kahvell/pcb_projekt1/projekt/soldermask_stop_bottom.pdf

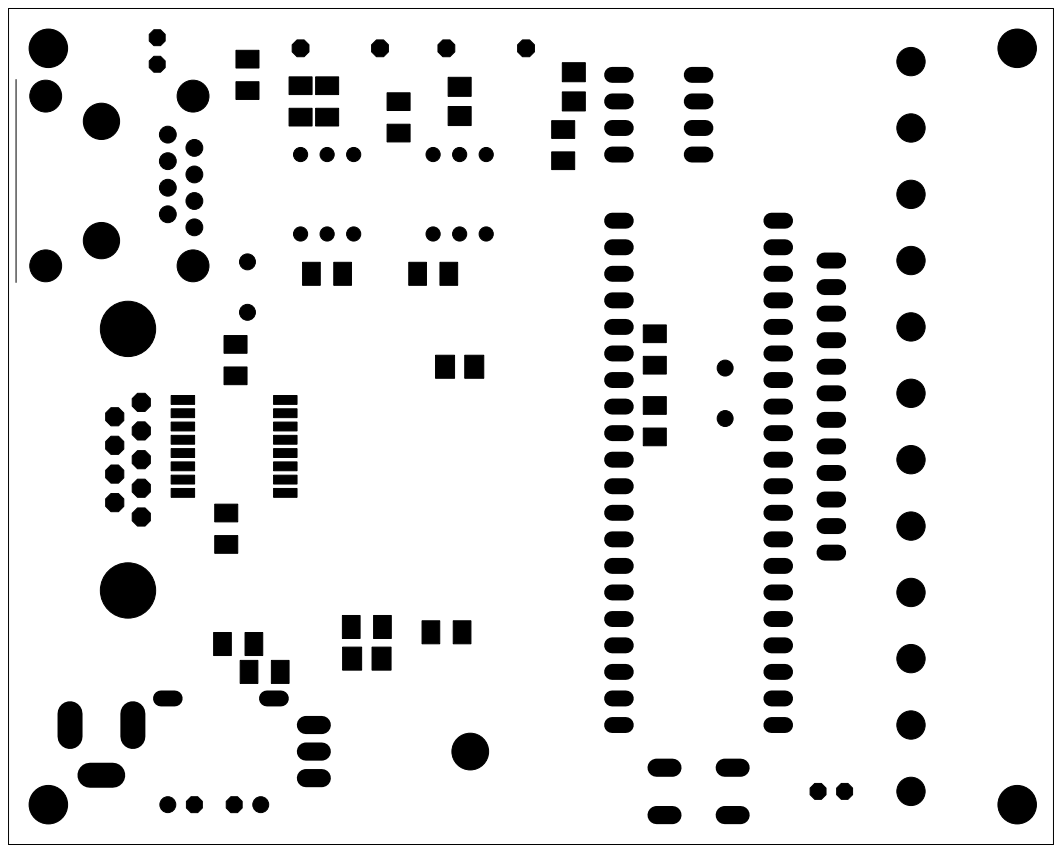
[picture p11: page 1]
