kahvell/pcb_projekt1/projekt/soldermask_stop_top.pdf

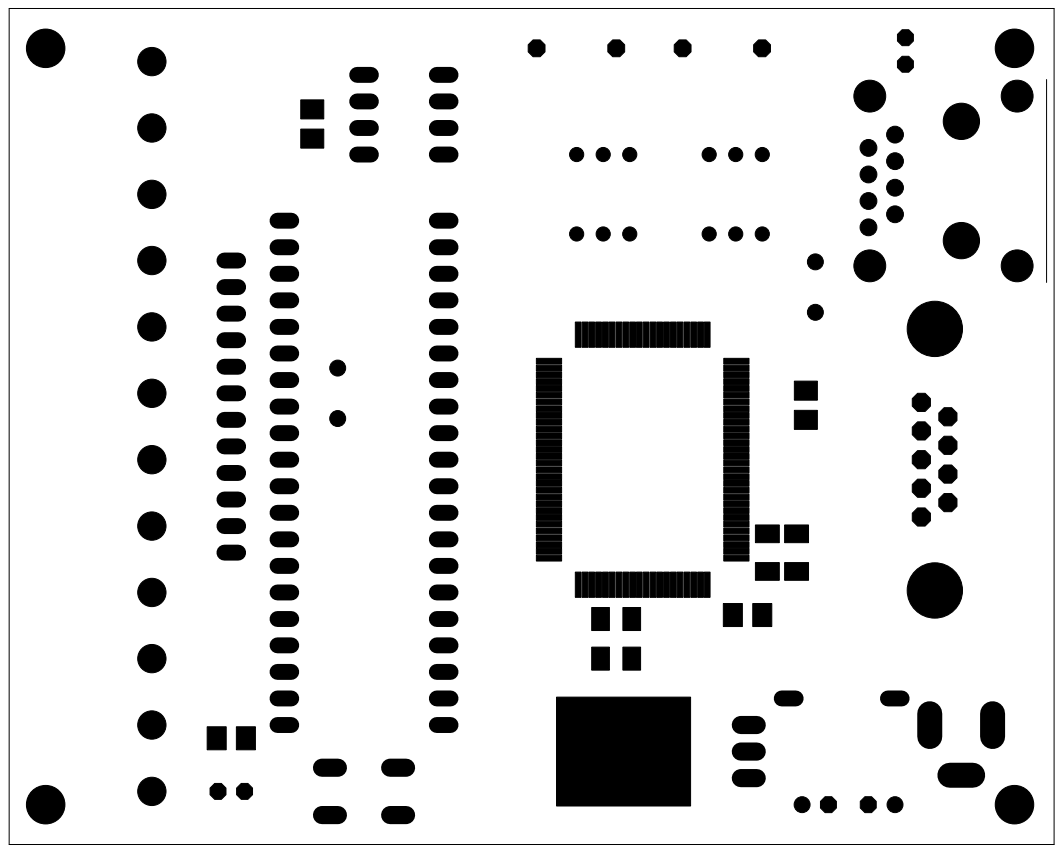
[picture p12: page 1]
