kahvell/pcb_projekt1/tutorial2/Eval/Eval.pdf

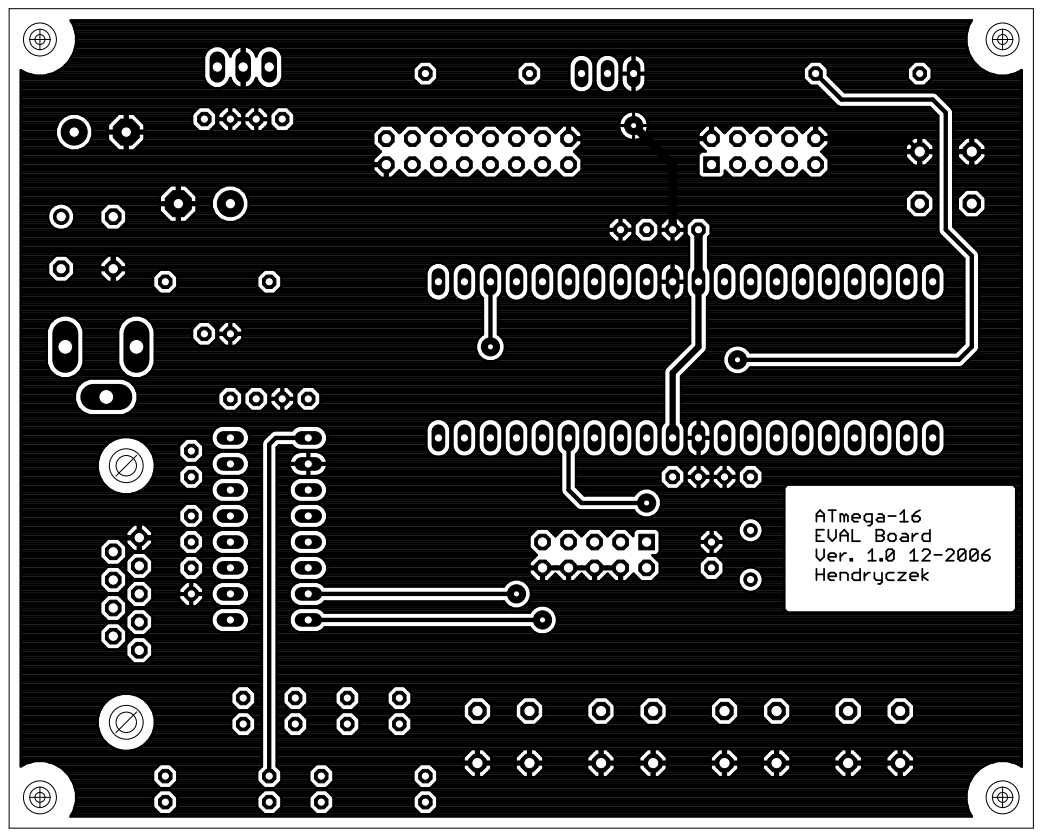
[picture p13: page 1]
