kahvell/pcb_projekt1/projekt/bottom.pdf

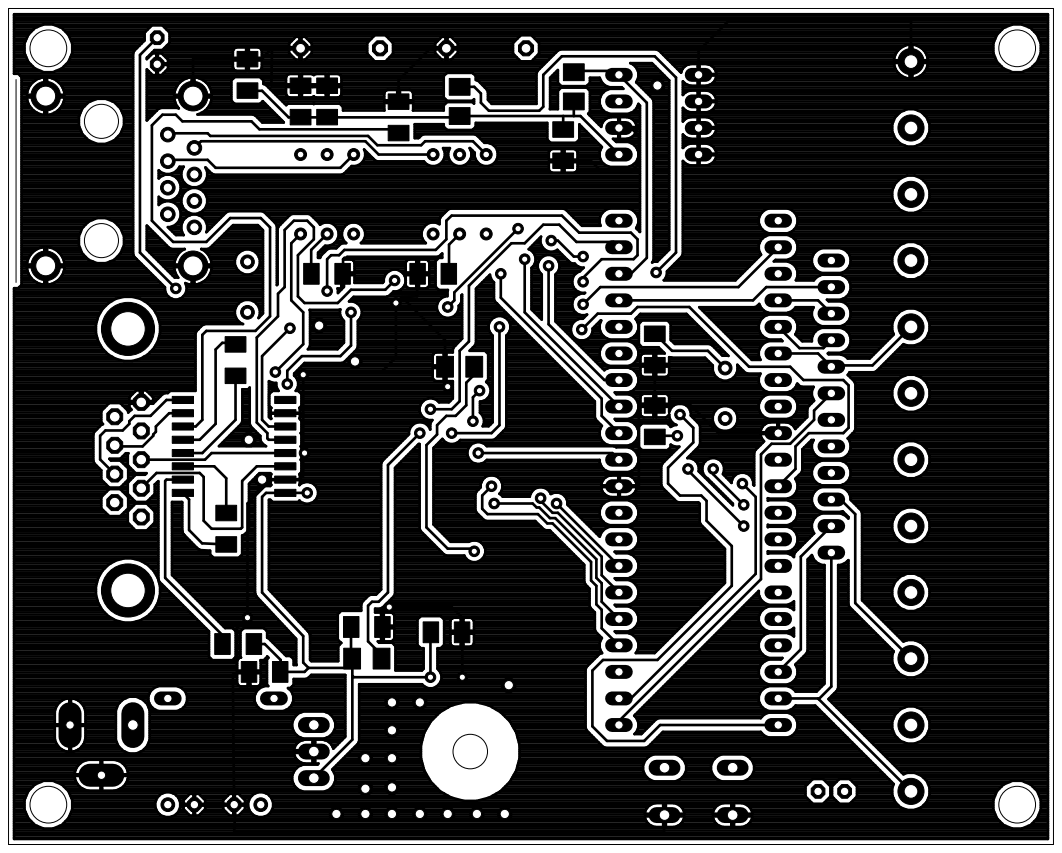
[picture p14: page 1]
