kahvell/pcb_projekt1/projekt/silkscreen_bottom.pdf

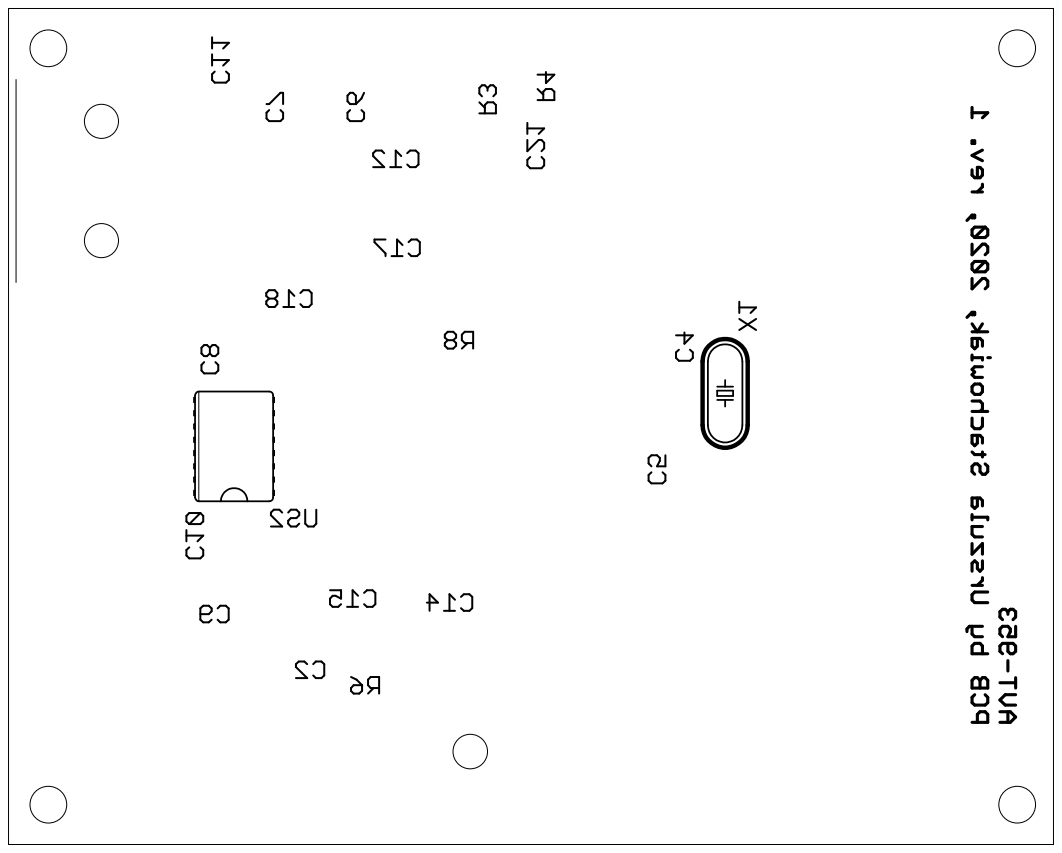
[picture p15: page 1]
