kahvell/pcb_projekt1/projekt/silkscreen_top.pdf

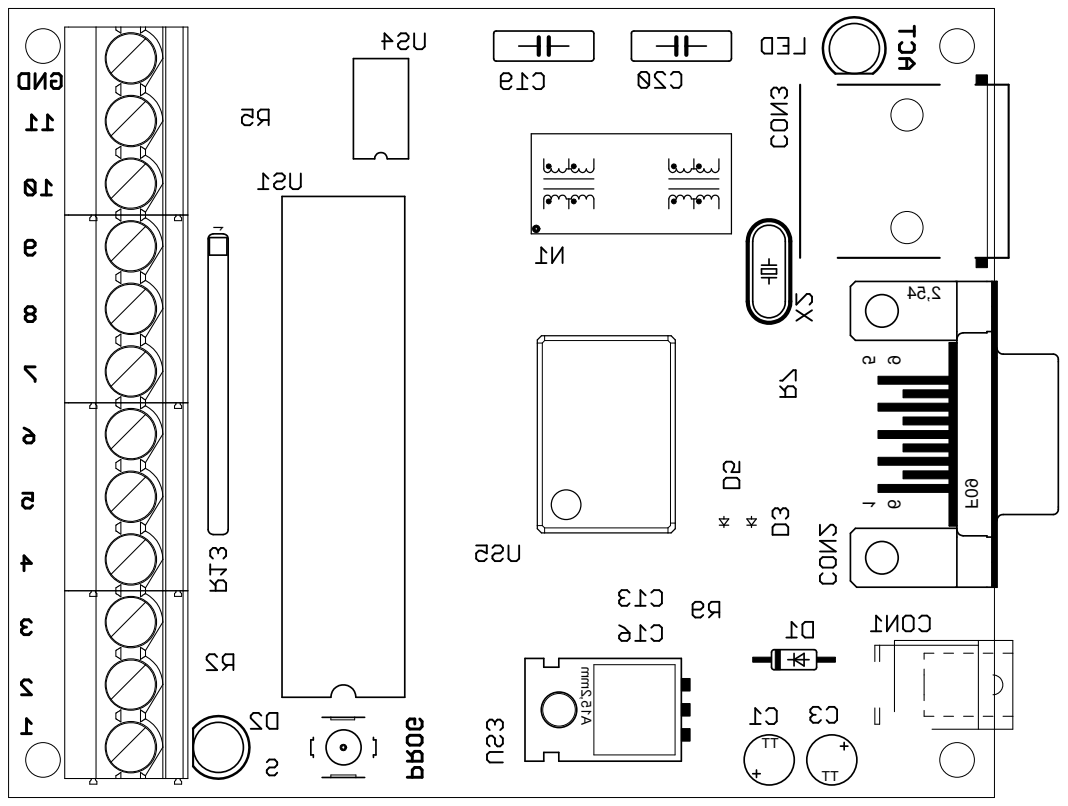
[picture p16: page 1]
