kahvell/pcb_projekt1/projekt/top.pdf

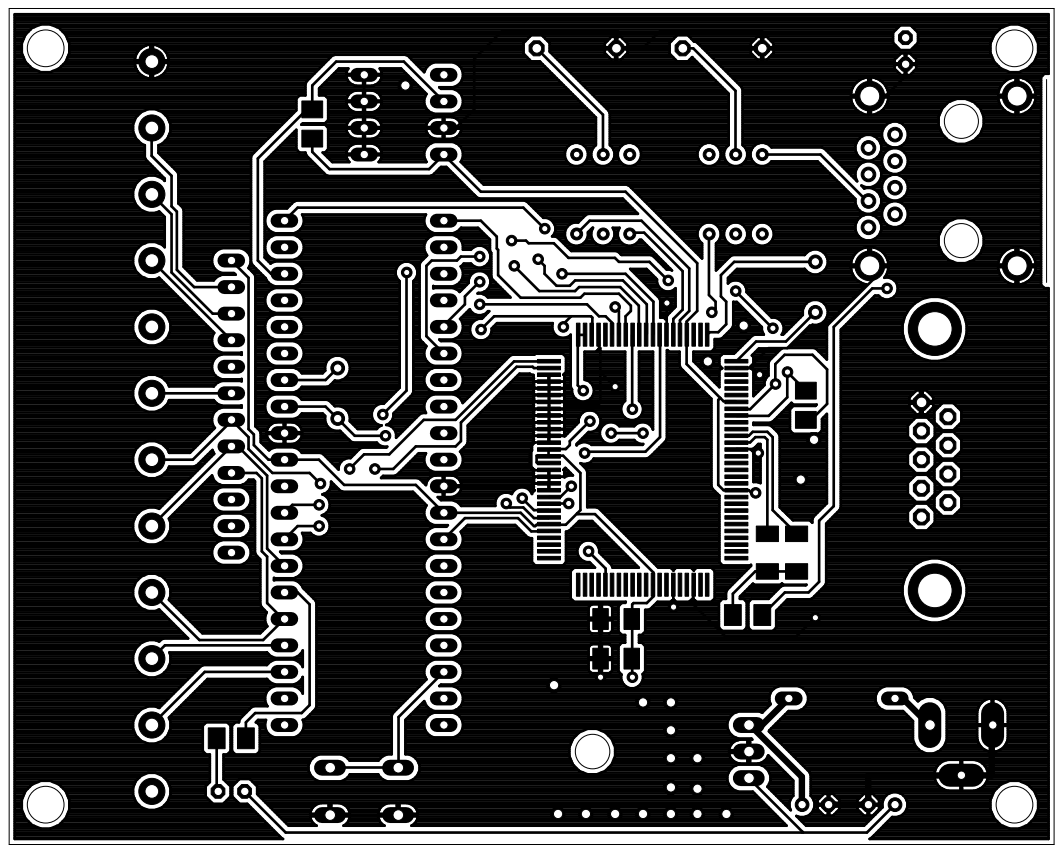
[picture p17: page 1]
