kahvell/pcb_projekt1/(list of files, drawings)

Other design files:
projekt/fw/8999/Cyfrowe wejscia LAN.PCB
