kahvell/pcb_projekt1/projekt/avt953.brd

## EAGLE design projekt/avt953.brd (2020-05-01)

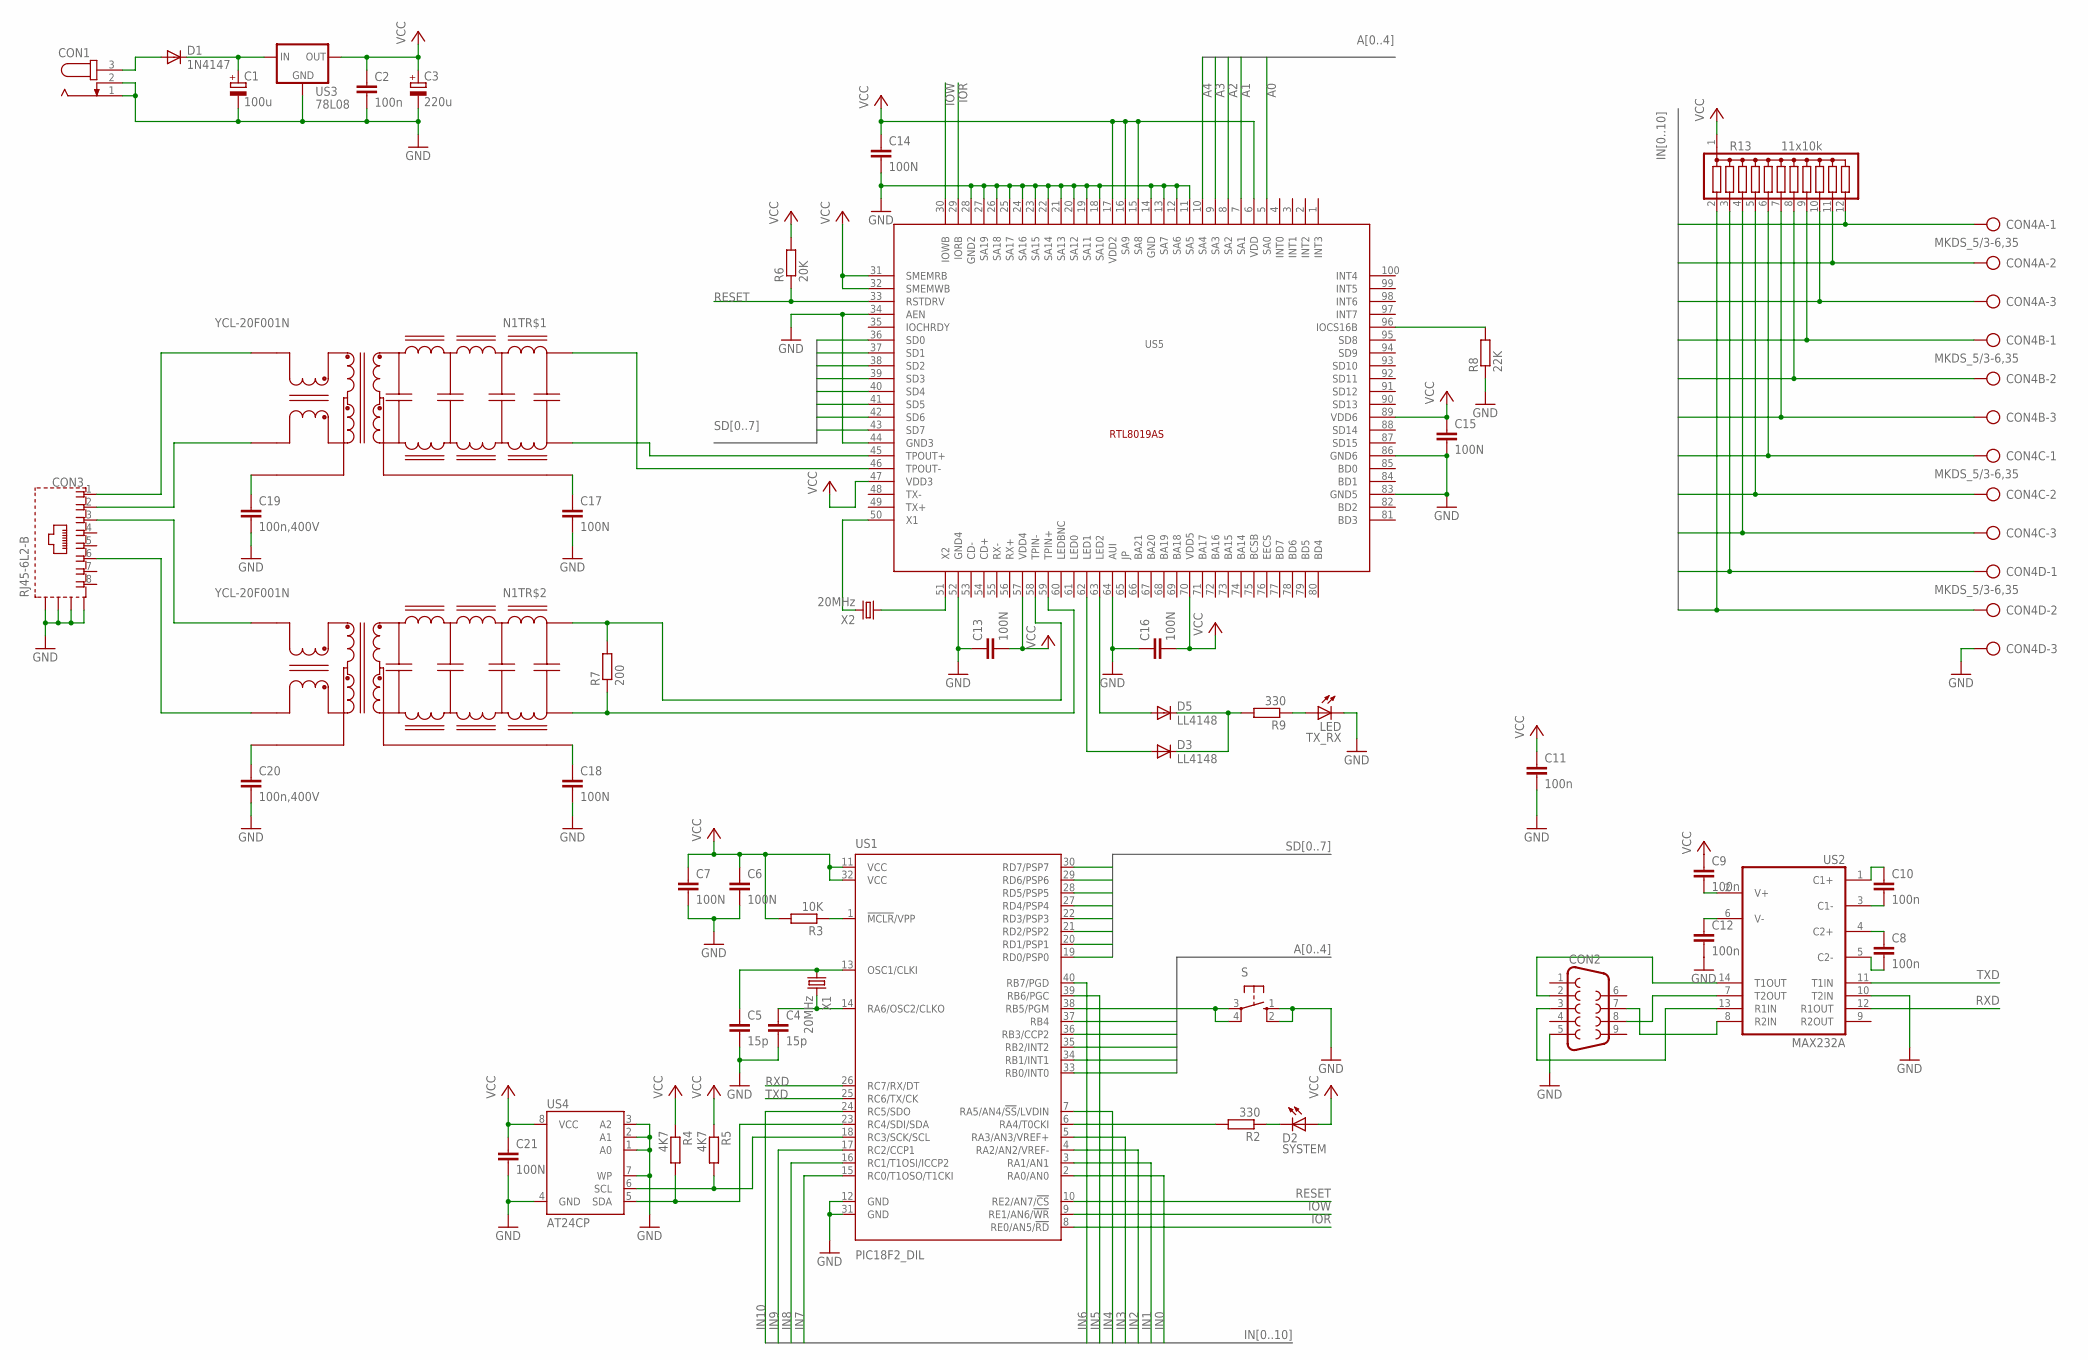
[picture p18: schematic avt953.sch]

Parts:
C1: 100u; TT2D5
C2, C8, C9, C10, C11, C12: 100n; C1206K
C3: 220u; TT2D5
C4, C5: 15p; C1206K
C6, C7, C13, C14, C15, C16, C17, C18, C21: 100N; C1206K
C19, C20: 100n,400V; C075-032X103
CON1: JACK-PLUG0; SPC4077
CON2: F09HP
CON3: RJ45-6L2-B; RJ45-SHIELD2
CON4A, CON4B, CON4C, CON4D: MKDS_5/3-6,35; MKDS_5/3-635
D1: 1N4147; DO35-10
D2: SYSTEM; LED5MM
D3, D5: LL4148; SOD-123_MINI-SMA
LED: TX_RX; LED5MM
N1: YCL-20F001N; DIP
R2, R9: 330; M3216
R3: 10K; M3216
R4, R5: 4K7; M3216
R6: 20K; M3216
R7: 200; M3216
R8: 22K; M3216
R13: 11x10k; SIL12
S: 10-XX; B3F-10XX
US1: PIC18F2_DIL; DIL40
US2: MAX232A; SO16L
US3: 78L08; 78XXL
US4: AT24CP; DIL08
US5: RTL8019AS
X1, X2: 20MHz; HC49/S

Connections:
A0: US1.33 (RB0/INT0), US5.5 (SA0)
A1: US1.34 (RB1/INT1), US5.7 (SA1)
A2: US1.35 (RB2/INT2), US5.8 (SA2)
A3: US1.36 (RB3/CCP2), US5.9 (SA3)
A4: US1.37 (RB4), US5.10 (SA4)
GND: C1.-, C2.2, C3.-, C4.2, C5.2, C6.2, C7.2, C11.2, C12.2, C13.1, C14.2, C15.2, C16.1, C17.2, C18.2, C19.2, C20.2, C21.2, CON1.1, CON1.2, CON2.5, CON3.S1 (S), CON3.S2 (S), CON3.S3 (S), CON3.S4 (S), CON4D.3, LED.K (C), R8.1, S.1 (S), S.2 (S1), US1.12 (GND), US1.31 (GND), US2.10 (T2IN), US2.15 (GND), US3.GND, US4.1 (A0), US4.2 (A1), US4.3 (A2), US4.4 (GND), US4.7 (WP), US5.11 (SA5), US5.12 (SA6), US5.13 (SA7), US5.14 (GND), US5.18 (SA10), US5.19 (SA11), US5.20 (SA12), US5.21 (SA13), US5.22 (SA14), US5.23 (SA15), US5.24 (SA16), US5.25 (SA17), US5.26 (SA18), US5.27 (SA19), US5.28 (GND2), US5.34 (AEN), US5.44 (GND3), US5.52 (GND4), US5.64 (AUI), US5.83 (GND5), US5.86 (GND6)
IN0: CON4A.1, R13.12, US1.2 (RA0/AN0)
IN1: CON4A.2, R13.11, US1.3 (RA1/AN1)
IN2: CON4A.3, R13.10, US1.4 (RA2/AN2/VREF-)
IN3: CON4B.1, R13.9, US1.5 (RA3/AN3/VREF+)
IN4: CON4B.2, R13.8, US1.7 (RA5/AN4/!SS!/LVDIN)
IN5: CON4B.3, R13.7, US1.39 (RB6/PGC)
IN6: CON4C.1, R13.6, US1.40 (RB7/PGD)
IN7: CON4C.2, R13.5, US1.15 (RC0/T1OSO/T1CKI)
IN8: CON4C.3, R13.4, US1.16 (RC1/T1OSI/ICCP2)
IN9: CON4D.1, R13.3, US1.17 (RC2/CCP1)
IN10: CON4D.2, R13.2, US1.24 (RC5/SDO)
IOR: US1.8 (RE0/AN5/!RD), US5.29 (IORB)
IOW: US1.9 (RE1/AN6/!WR), US5.30 (IOWB)
unnamed: C9.2, US2.2 (V+)
unnamed: C12.1, US2.6 (V-)
unnamed: C10.2, US2.3 (C1-)
unnamed: C10.1, US2.1 (C1+)
unnamed: C8.1, US2.4 (C2+)
unnamed: C8.2, US2.5 (C2-)
unnamed: CON2.2, US2.14 (T1OUT)
unnamed: CON2.8, US2.7 (T2OUT)
unnamed: CON2.3, US2.13 (R1IN)
unnamed: CON2.7, US2.8 (R2IN)
unnamed: CON1.3, D1.A
unnamed: C1.+, D1.C, US3.IN
unnamed: CON3.1, N1.P$16
unnamed: CON3.2, N1.P$14
unnamed: CON3.3, N1.P$11
unnamed: CON3.6, N1.P$9
unnamed: C19.1, N1.P$15
unnamed: C20.1, N1.P$10
unnamed: C18.1, N1.P$7
unnamed: C17.1, N1.P$2
unnamed: N1.P$3, US5.45 (TPOUT+)
unnamed: N1.P$8, R7.1, US5.59 (TPIN+)
unnamed: N1.P$1, US5.46 (TPOUT-)
unnamed: US5.50 (X1), X2.2
unnamed: N1.P$6, R7.2, US5.58 (TPIN-)
unnamed: D3.A, US5.62 (LED1)
unnamed: R8.2, US5.96 (IOCS16B)
unnamed: US5.51 (X2), X2.1
unnamed: D5.A, US5.63 (LED2)
unnamed: D3.C, D5.C, R9.2
unnamed: LED.A, R9.1
unnamed: C5.1, US1.13 (OSC1/CLKI), X1.1
unnamed: C4.1, US1.14 (RA6/OSC2/CLKO), X1.2
unnamed: R4.2, US1.23 (RC4/SDI/SDA), US4.5 (SDA)
unnamed: R3.1, US1.1 (!MCLR!/VPP)
unnamed: R2.2, US1.6 (RA4/T0CKI)
unnamed: R5.2, US1.18 (RC3/SCK/SCL), US4.6 (SCL)
unnamed: D2.K (C), R2.1
unnamed: S.3, S.4 (P1), US1.38 (RB5/PGM)
RESET: R6.1, US1.10 (RE2/AN7/!CS), US5.33 (RSTDRV)
RXD: US1.26 (RC7/RX/DT), US2.12 (R1OUT)
SD0: US1.19 (RD0/PSP0), US5.36 (SD0)
SD1: US1.20 (RD1/PSP1), US5.37 (SD1)
SD2: US1.21 (RD2/PSP2), US5.38 (SD2)
SD3: US1.22 (RD3/PSP3), US5.39 (SD3)
SD4: US1.27 (RD4/PSP4), US5.40 (SD4)
SD5: US1.28 (RD5/PSP5), US5.41 (SD5)
SD6: US1.29 (RD6/PSP6), US5.42 (SD6)
SD7: US1.30 (RD7/PSP7), US5.43 (SD7)
TXD: US1.25 (RC6/TX/CK), US2.11 (T1IN)
VCC: C2.1, C3.+, C6.1, C7.1, C9.1, C11.1, C13.2, C14.1, C15.1, C16.2, C21.1, D2.A, R3.2, R4.1, R5.1, R6.2, R13.1, US1.11 (VCC), US1.32 (VCC), US2.16 (VCC), US3.OUT, US4.8 (VCC), US5.6 (VDD), US5.15 (SA8), US5.16 (SA9), US5.17 (VDD2), US5.31 (SMEMRB), US5.32 (SMEMWB), US5.47 (VDD3), US5.57 (VDD4), US5.70 (VDD5), US5.89 (VDD6)

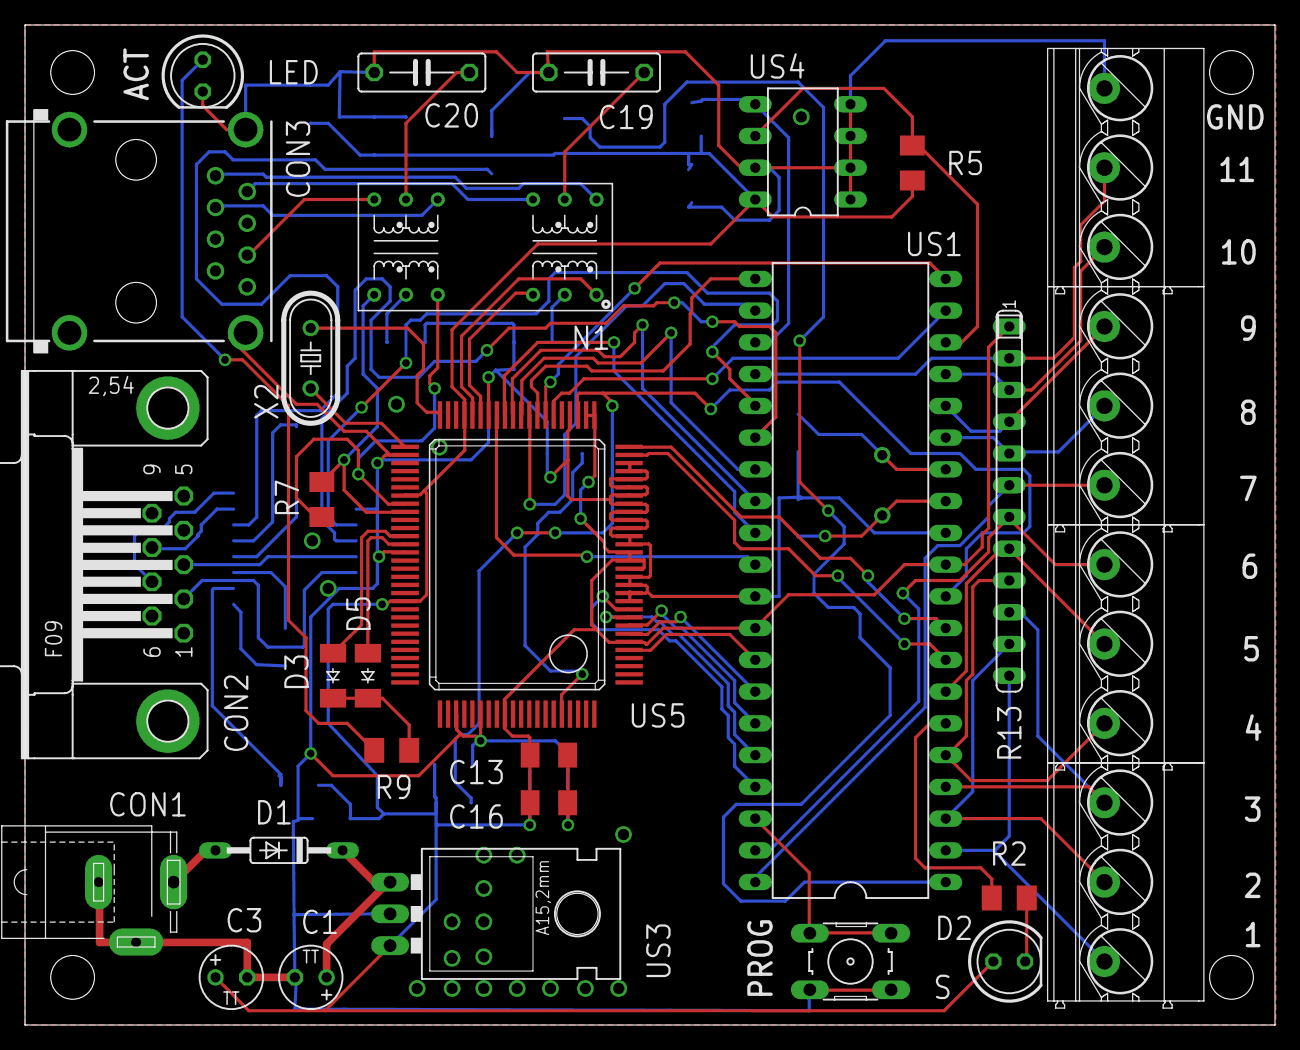
[picture p19: board avt953.brd from above]

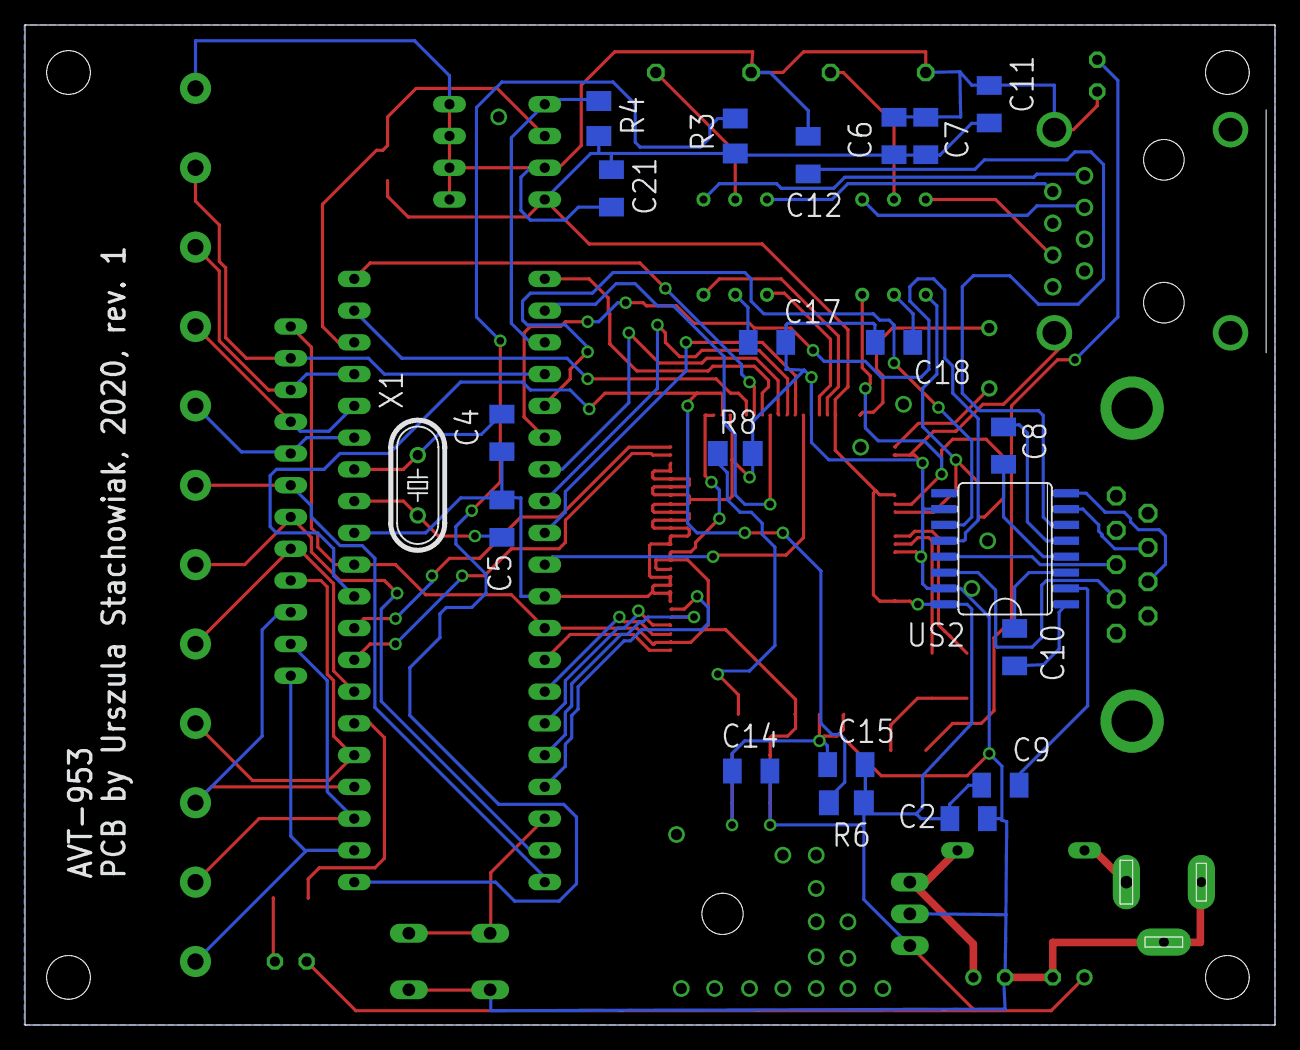
[picture p20: board avt953.brd from below]

Board: 2 copper layers, 100.0 x 80.0 mm, 51 parts (21 on the bottom side), 70 nets.
