kahvell/pcb_projekt1/tutorial2/Eval/Eval_autorouter.brd

## EAGLE design tutorial2/Eval/Eval_autorouter.brd (2020-05-02)

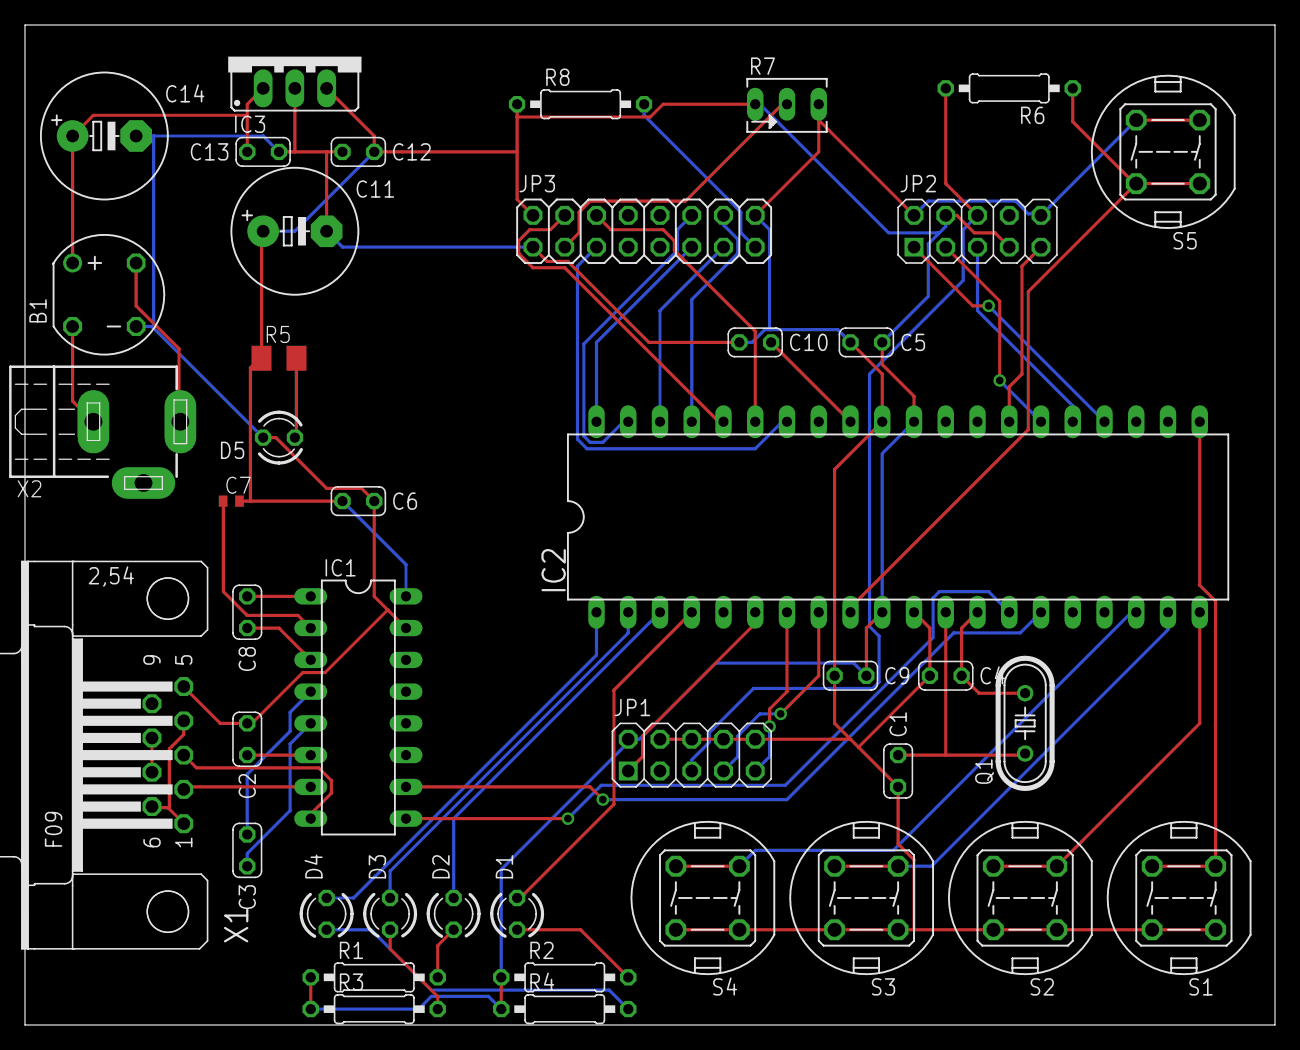
[picture p21: board Eval_autorouter.brd from above]

Board: 2 copper layers, 100.0 x 80.0 mm, 42 parts (0 on the bottom side), 51 nets.

Parts:
B1: RB1A
C1, C4: 33pF; C025-024X044
C2, C3, C5, C6, C8, C9, C10, C12, C13: 100nF; C025-024X044
C7: 100nF; C0402
C11, C14: 470u/25V; E5-10,5
D1, D2, D3, D4: Red; LED3MM
D5: Green; LED3MM
IC1: MAX232; DIL16
IC2: MEGA16-P; DIL40
IC3: 7805; 78XXS
JP1, JP2: 2x5; 2X05
JP3: 2x8; 2X08
Q1: 16MHz; HC49/S
R1, R2, R3, R4: 220R; 0207/10@1
R5: 220R; M1206
R6: 510R; 0207/10@1
R7: 10k; B64Y
R8: 22R; 0207/10@1
S1, S2, S3, S4, S5: DTE6
X1: F09H
X2: NEB21R

Connections:
+5V: C5.2, C6.1, C7.2, C9.2, C11.+, C12.2, IC1.16, IC2.10, IC2.30, IC3.OUT, JP1.2, JP2.4, JP2.7, JP3.2, R1.1, R2.1, R3.1, R4.1, R5.1, R7.E, R8.1
/RESET: IC2.9, R6.1, S5.1, S5.2
/RESET_ISP: JP1.5, JP2.6, R6.2
DB4: IC2.40, JP3.11
DB5: IC2.39, JP3.12
DB6: IC2.38, JP3.13
DB7: IC2.37, JP3.14
E: IC2.35, JP3.6
GND: B1.-, C1.1, C2.1, C4.1, C5.1, C6.2, C9.1, C10.1, C11.-, C12.1, C13.1, C14.-, D5.K, IC1.15, IC2.11, IC2.31, IC3.GND, JP1.4, JP1.6, JP1.8, JP1.10, JP2.2, JP2.10, JP3.1, JP3.16, R7.A, S1.1, S1.2, S2.1, S2.2, S3.1, S3.2, S4.1, S4.2, S5.3, S5.4, X1.5
LED0: D4.K, IC2.1
LED1: D3.K, IC2.2
LED2: D2.K, IC2.3
LED3: D1.K, IC2.4
LED-A: JP3.15, R8.2
MISO: IC2.7, JP1.9
MOSI: IC2.6, JP1.1
unnamed: D4.A, R4.2
unnamed: D3.A, R3.2
unnamed: D2.A, R1.2
unnamed: D1.A, R2.2
unnamed: C10.2, IC2.32
unnamed: C2.2, IC1.6
unnamed: C7.1, IC1.2
unnamed: C3.2, IC1.5
unnamed: C3.1, IC1.4
unnamed: C8.2, IC1.3
unnamed: C8.1, IC1.1
unnamed: C4.2, IC2.13, Q1.2
unnamed: C1.2, IC2.12, Q1.1
unnamed: X1.1, X1.4, X1.6
unnamed: D5.A, R5.2
unnamed: B1.AC2, X2.-
unnamed: X1.7, X1.8
unnamed: B1.AC1, X2.+
unnamed: B1.+, C13.2, C14.+, IC3.IN
R/W: IC2.34, JP3.5
RS: IC2.36, JP3.4
RS232-RX0: IC1.8, X1.3
RS232-TX0: IC1.7, X1.2
RXD0: IC1.9, IC2.14
SCK: IC2.8, JP1.7
SW4: IC2.18, S4.3, S4.4
SW5: IC2.19, S3.3, S3.4
SW6: IC2.20, S2.3, S2.4
SW7: IC2.21, S1.3, S1.4
TCK: IC2.24, JP2.1
TDI: IC2.27, JP2.9
TDO: IC2.26, JP2.3
TMS: IC2.25, JP2.5
TXD0: IC1.10, IC2.15
V0: JP3.3, R7.S
