kahvell/pcb_projekt1/tutorial1/Sterownik/New_Project/sterownik.sch

## EAGLE design tutorial1/Sterownik/New_Project/sterownik.sch (2020-05-02)

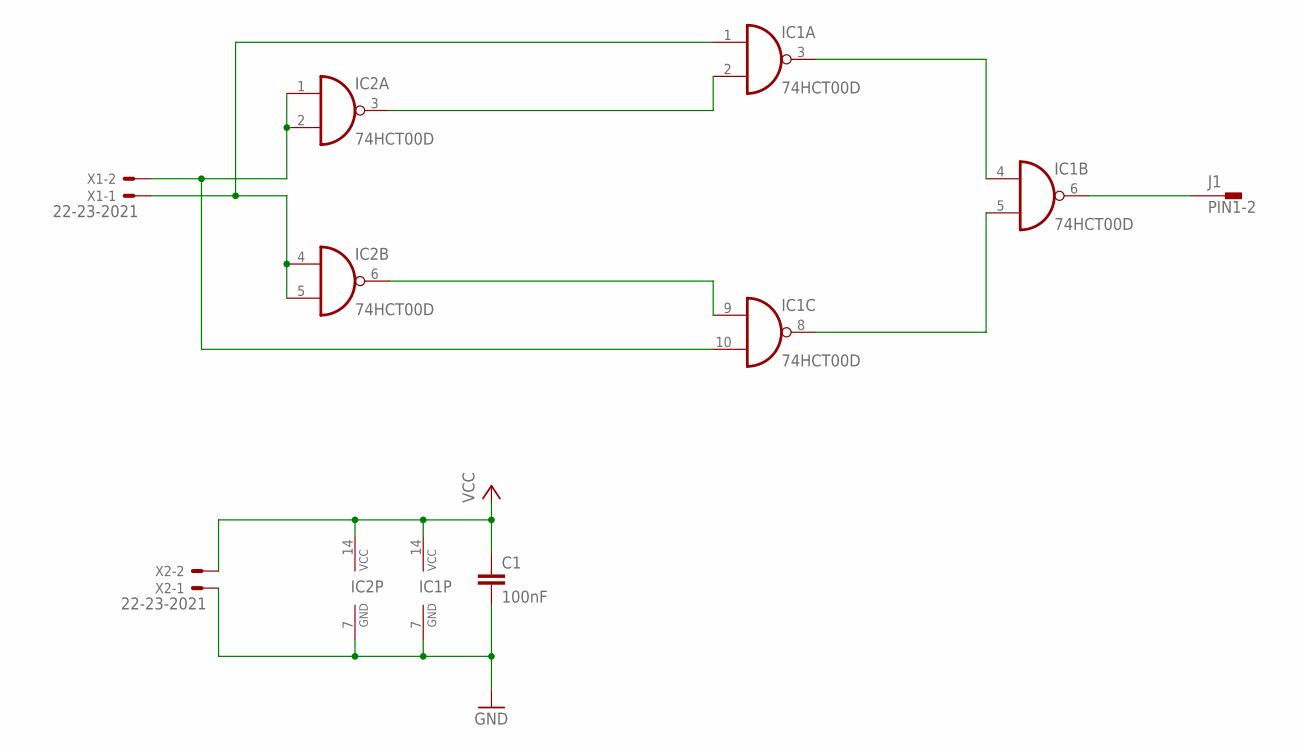
[picture p22: schematic sterownik.sch]

Parts:
C1: 100nF; C025-024X044
IC1, IC2: 74HCT00D; SO14
J1: PIN1-2; 62221
X1, X2: 22-23-2021

Connections:
GND: C1.2, IC1.7 (GND), IC2.7 (GND), X2.1
unnamed: IC1.10 (I1), IC2.1 (I0), IC2.2 (I1), X1.2
unnamed: IC1.1 (I0), IC2.4 (I0), IC2.5 (I1), X1.1
unnamed: IC1.2 (I1), IC2.3 (O)
unnamed: IC1.9 (I0), IC2.6 (O)
unnamed: IC1.3 (O), IC1.4 (I0)
unnamed: IC1.5 (I1), IC1.8 (O)
unnamed: IC1.6 (O), J1.1
VCC: C1.1, IC1.14 (VCC), IC2.14 (VCC), X2.2
