kahvell/pcb_projekt1/(commit log)

2020-04-23 Do biblioteki microchip.lbr dodano device PIC18F452 w obudowie DIL40.
2020-04-23 Umieszczono co bardziej nietypowe komponenty na schemacie i dobrano footprinty.
    [avt953.sch]
2020-04-23 Dopasowano nazwy na schemacie do wytycznych.
    [avt953.sch]
2020-04-28 Dodano firmware mikrokontrolera z projektu, zaciągnięty z archiwum Elektroniki Praktycznej.
    [Cyfrowe wejscia LAN.PCB]
2020-04-29 Dodano bibliotekę z transformatorem ethernetowym 10BASE-T YCL-20F001N. Umieszczono to trafo na schemacie.
    [avt953.sch]
2020-04-30 Zaprojektowano kompletny schemat układu.Przygotowano na jego podstawie pusty projekt płytki PCB i rozmieszczono co większe elementy.
    [avt953.brd, avt953.sch]
2020-05-01 Przeprowadzono test ERC na schemacie i poprawiono zaraportowane błędy.
    [avt953.sch]
2020-05-01 Wstępnie rozmieszczono wszystkie elementy na projekcie płytki PCB.
    [avt953.brd]
2020-05-01 Dodano otwory montażowe M3 w rogach płytki.
    [avt953.brd]
2020-05-01 Przepuszczono płytkę przez autorouter z wynikiem 72,6%.
    [avt953.brd]
2020-05-01 Cofnięcie autoroutera. Zmiana kolejności wyprowadzeń IN (bo pin GND) nie był zewnętrznym pinem.
    [avt953.brd]
2020-05-01 Przepuszczono płytkę jeszcze raz przez autorouter, rozluźniając kryteria dodania przelotek i zmiany kierunku ścieżek. Brzydko wyszło, ale wynik 100%.
    [avt953.brd]
2020-05-01 Poprawki po autorouterze. Usunięto sporo przelotek, a pozostałe oddalono od siebie.
    [avt953.brd]
2020-05-01 Dodano szablon testu DRC za https://www.allpcb.com/standard_pcb_manufacturing_capability.html. Poddano płytkę testowi i poprawiono drobne błędy.
    [avt953.brd]
2020-05-01 Nie było połączenia z masą w konektorze RS232.
    [avt953.sch]
2020-05-01 Oblano warstwy top i bottom masą. Uzupełniono przelotki.
    [avt953.brd]
2020-05-01 Poprawiono i uzupełniono opisy w silkscreenie warstwy top.
    [avt953.brd]
2020-05-01 Poprawiono krytyczny błąd. Trzy elementy SMD na warstwie bottom nachodziły na siebie.
    [avt953.brd]
2020-05-01 Uzupełniono silkscreen na warstwie bottom.
    [avt953.brd]
2020-05-01 Włączono wyświetlanie wszystkich standardowych warstw.
    [avt953.brd]
2020-05-01 Dodano pliki gerber zgodnie z wytycznymi allpcb.com
2020-05-02 Przeniesiono projekt do podfolderu na... projekt.
    [Cyfrowe wejscia LAN.PCB, avt953.brd, avt953.sch]
2020-05-02 Dodano rozwiązania z trzech części tutoriala.
    [Eval.sch, Eval_autorouter.brd, Evals.brd, sterownik.sch]
